Ayer8315/earthquake-sms-alert/muhtasp2.ioc

Mcu.UserName=STM32F103C8Tx
PA0-WKUP.GPIO_Label=VIB_SENSOR
PA0-WKUP.Signal=GPXTI0
PA10.Signal=USART1_RX
PA13.Signal=SYS_JTMS-SWDIO
PA14.Signal=SYS_JTCK-SWCLK
PA2.Signal=GPIO_Input
PA3.Signal=GPIO_Input
PA4.Signal=GPIO_Input
PA5.Signal=GPIO_Output
PA6.Signal=GPIO_Input
PA9.Signal=USART1_TX
PB10.Signal=I2C2_SCL
PB11.Signal=I2C2_SDA
PC13-TAMPER-RTC.Signal=GPIO_Output
